Jackhammer9/Ottolink/CAD/Designed/UpperArm.stp

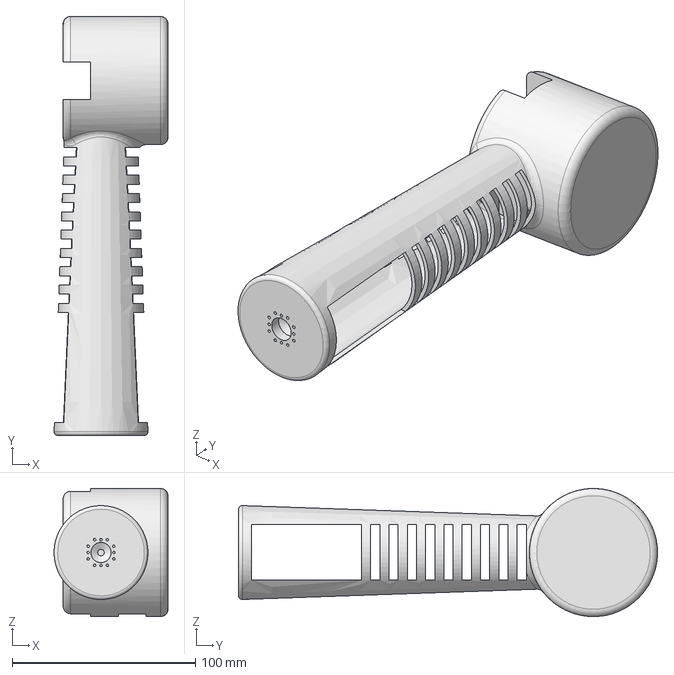
[picture p2: CAD file, 2026-09-29]
CAD/Designed/UpperArm.stp
62.2 x 228.9 x 70.0 mm
