Jackhammer9/Ottolink/Sim/meshes/rollmotor.stl

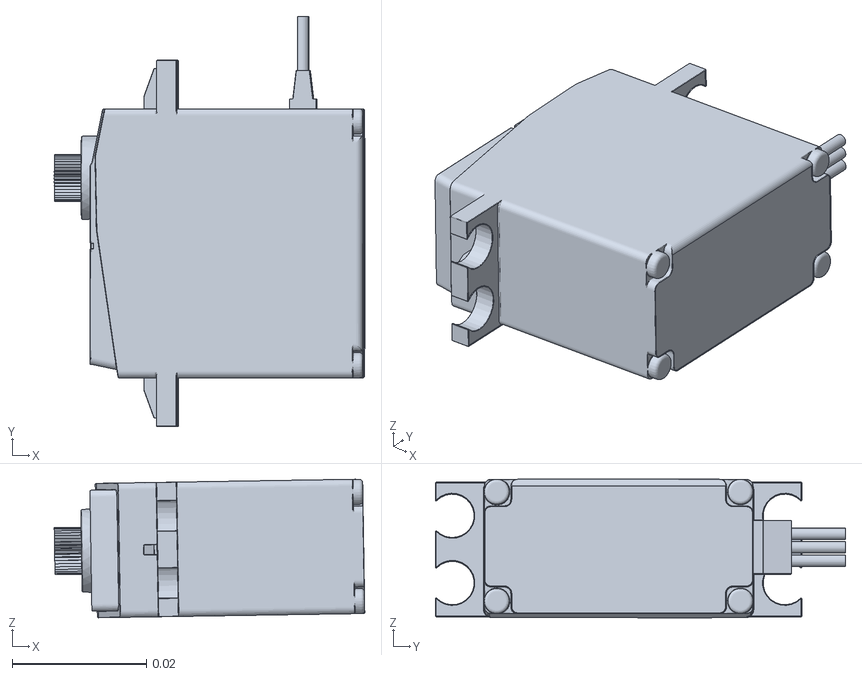
[picture p3: CAD file, 2026-09-29]
Sim/meshes/rollmotor.stl
0.0462 x 0.061 x 0.0206
