Jackhammer9/Ottolink/CAD/Designed/LowArm.stp

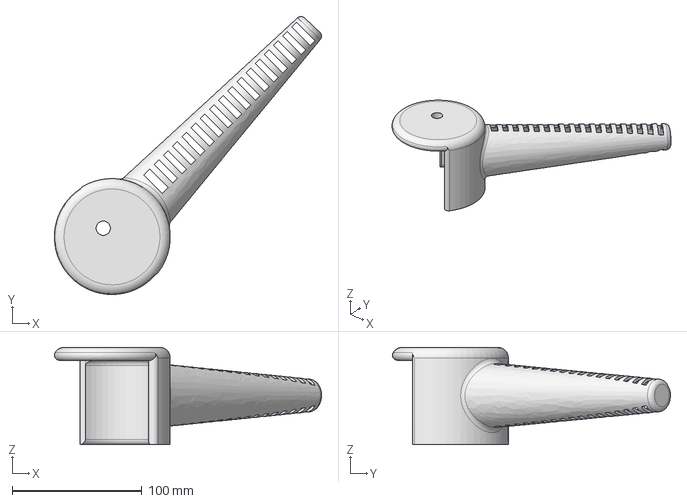
[picture p4: CAD file, 2026-09-29]
CAD/Designed/LowArm.stp
206.2 x 214.6 x 75.0 mm
