Jackhammer9/Ottolink/Sim/meshes/upperarm_1.stl

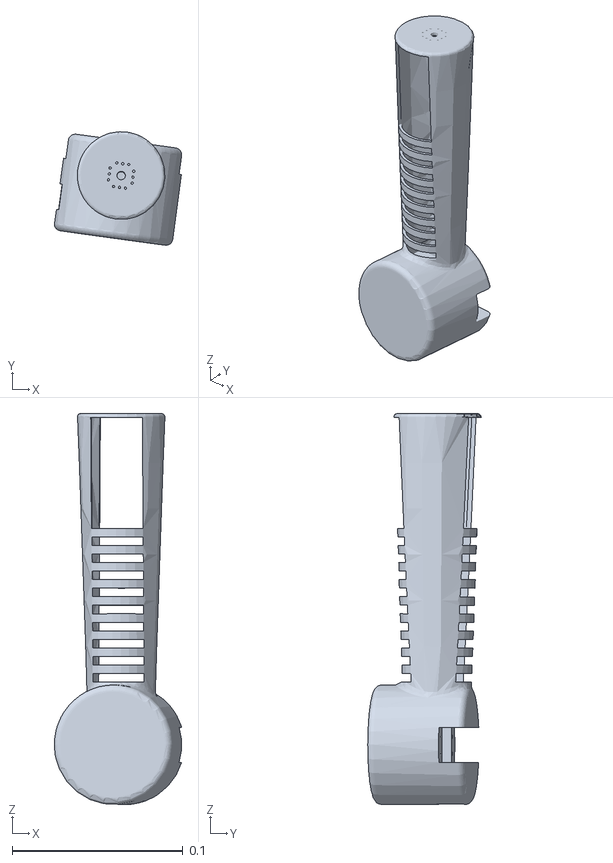
[picture p5: CAD file, 2026-09-29]
Sim/meshes/upperarm_1.stl
0.0746 x 0.0665 x 0.229
