Jackhammer9/Ottolink/CAD/Designed/RollServoMount.stp

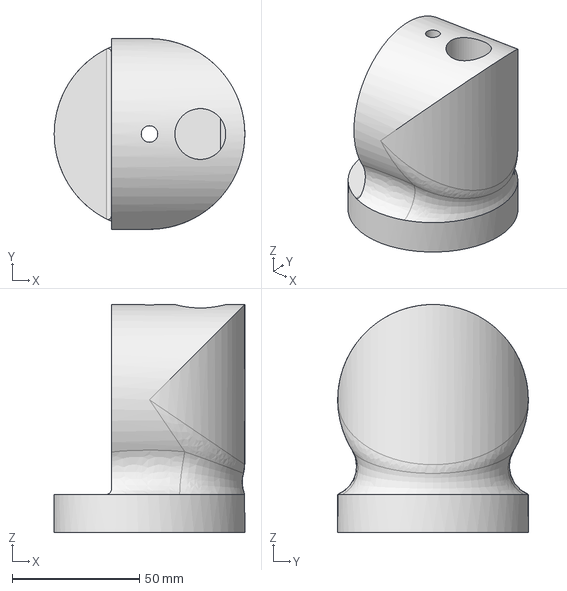
[picture p6: CAD file, 2026-09-29]
CAD/Designed/RollServoMount.stp
75.0 x 75.0 x 89.7 mm
