Jackhammer9/Ottolink/Sim/meshes/yawmotorholder.stl

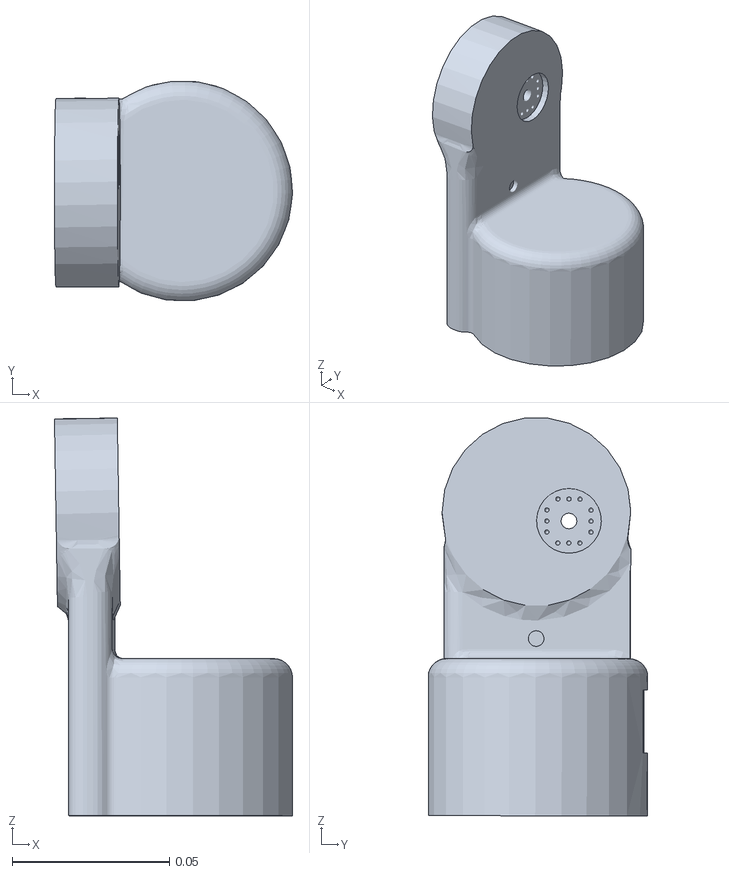
[picture p7: CAD file, 2026-09-29]
Sim/meshes/yawmotorholder.stl
0.0757 x 0.0698 x 0.127
