Jackhammer9/Ottolink/CAD/Designed/YawMotorHolder.stp

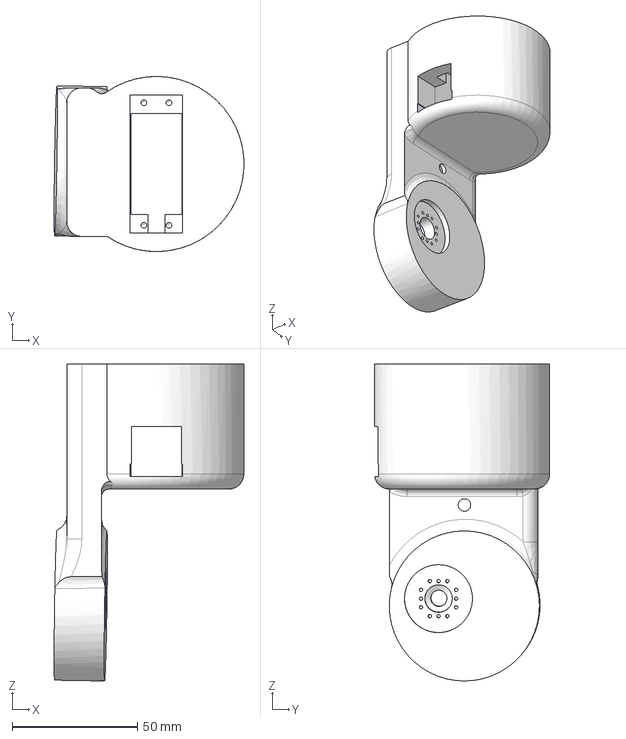
[picture p8: CAD file, 2026-09-29]
CAD/Designed/YawMotorHolder.stp
75.9 x 70.0 x 126.7 mm
