Jackhammer9/Ottolink/Sim/meshes/pitchmotor.stl

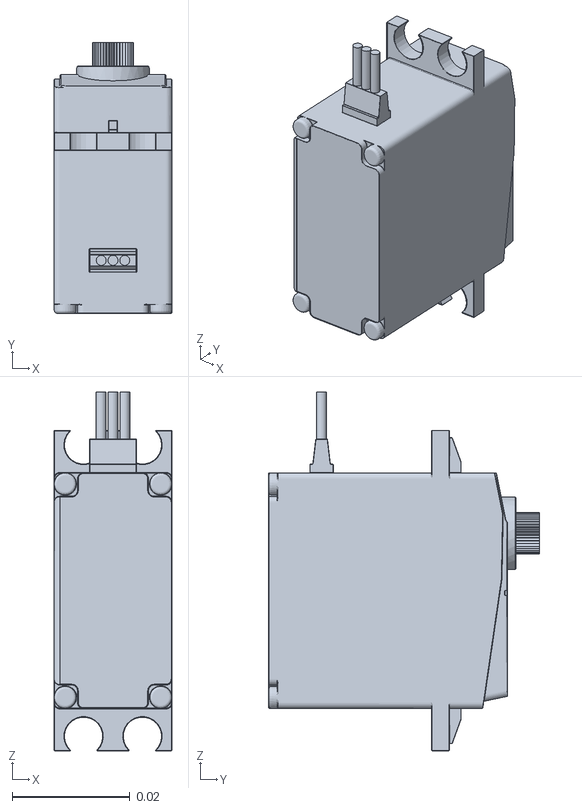
[picture p9: CAD file, 2026-09-29]
Sim/meshes/pitchmotor.stl
0.02 x 0.046 x 0.061
