Jackhammer9/Ottolink/CAD/Designed/PitchMotorHolder.stp

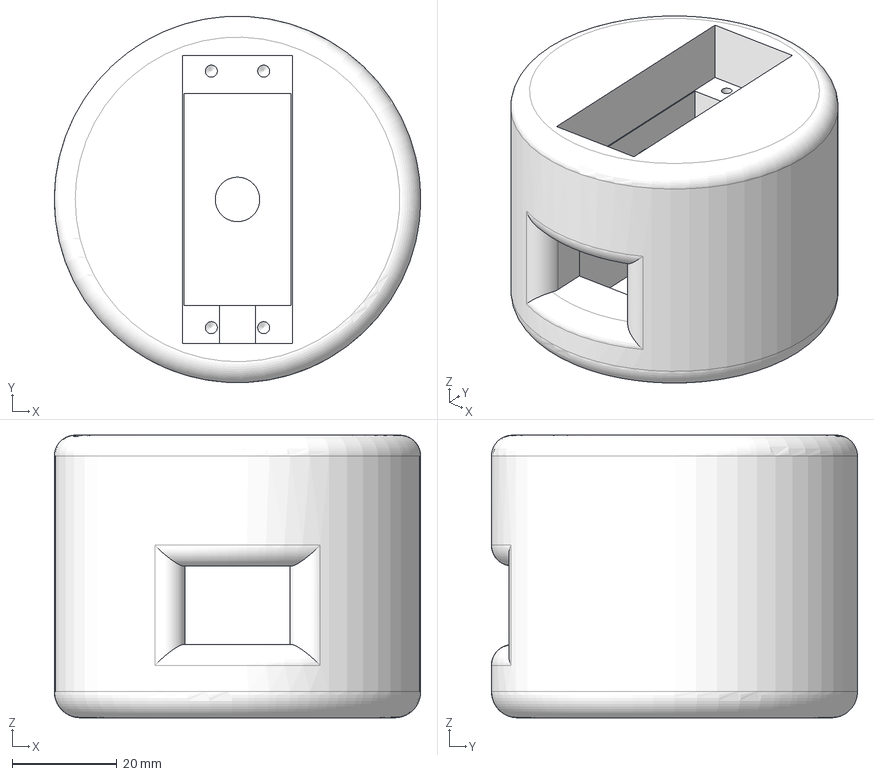
[picture p10: CAD file, 2026-09-29]
CAD/Designed/PitchMotorHolder.stp
70.0 x 69.9 x 54.0 mm
