Jackhammer9/Ottolink/Sim/meshes/yawhorn.stl

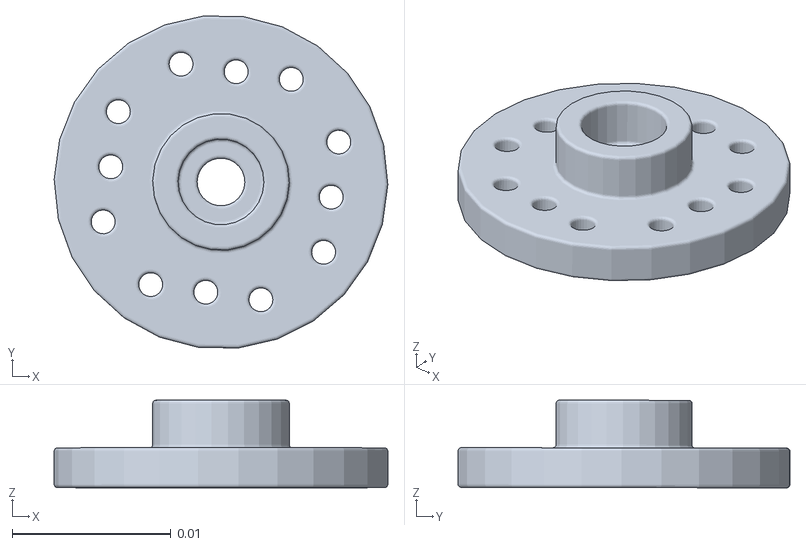
[picture p11: CAD file, 2026-09-29]
Sim/meshes/yawhorn.stl
0.021 x 0.0209 x 0.00552
