Jackhammer9/Ottolink/Sim/meshes/elbow_horn.stl

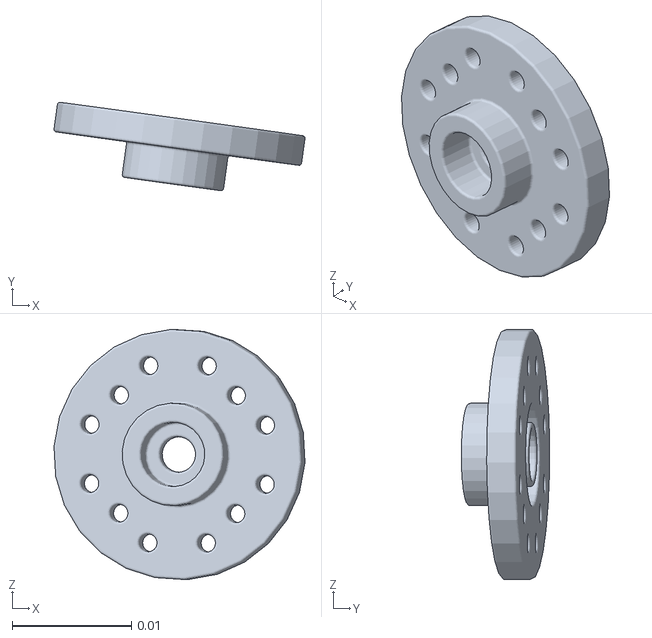
[picture p12: CAD file, 2026-09-29]
Sim/meshes/elbow_horn.stl
0.021 x 0.00741 x 0.021
