Jackhammer9/Ottolink/Sim/meshes/rollservomount_1.stl

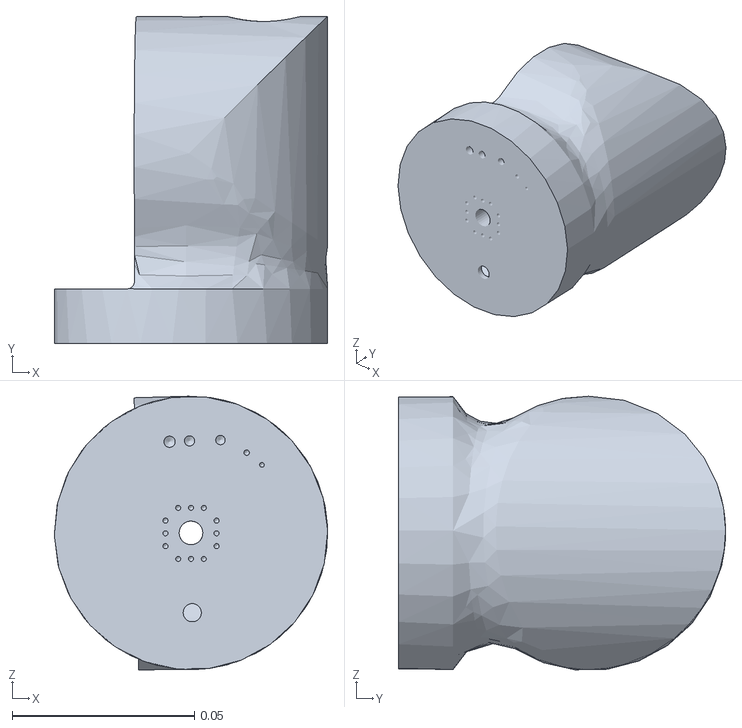
[picture p13: CAD file, 2026-09-29]
Sim/meshes/rollservomount_1.stl
0.075 x 0.0897 x 0.075
