Jackhammer9/Ottolink/Sim/meshes/pitchmotorholder_1.stl

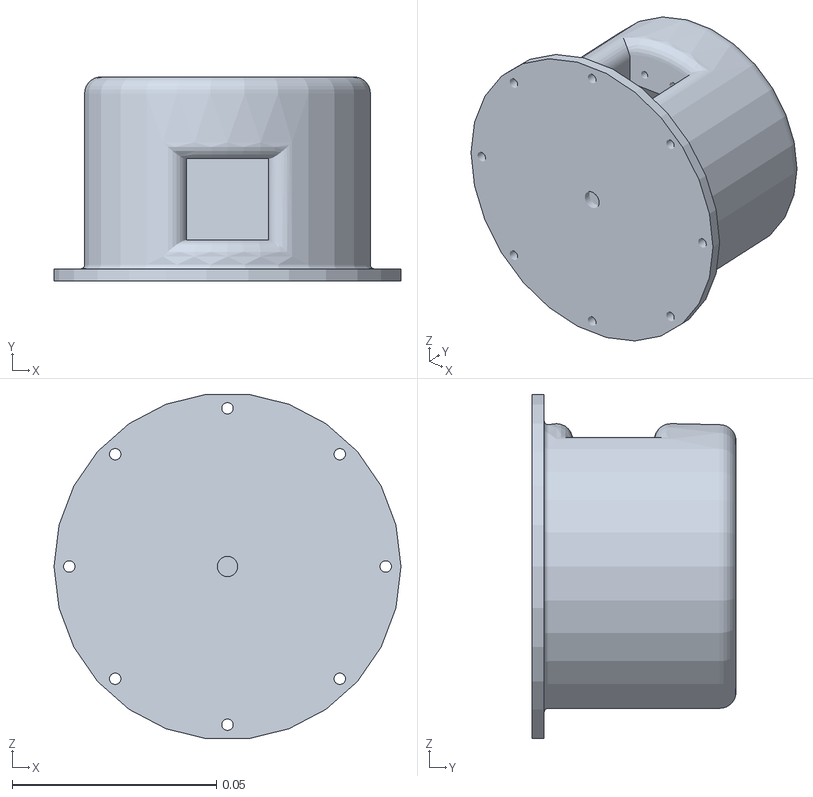
[picture p14: CAD file, 2026-09-29]
Sim/meshes/pitchmotorholder_1.stl
0.085 x 0.05 x 0.0844
