Jackhammer9/Ottolink/Sim/meshes/lowarm_1.stl

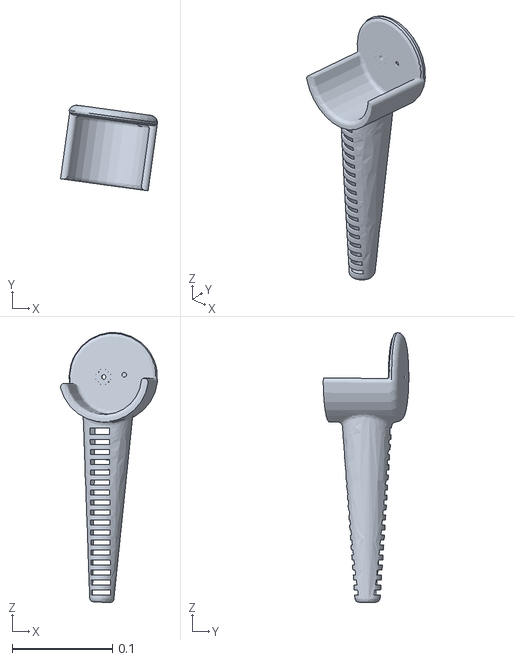
[picture p15: CAD file, 2026-09-29]
Sim/meshes/lowarm_1.stl
0.0968 x 0.0855 x 0.27
