Jackhammer9/Ottolink/Sim/meshes/elbowmotor.stl

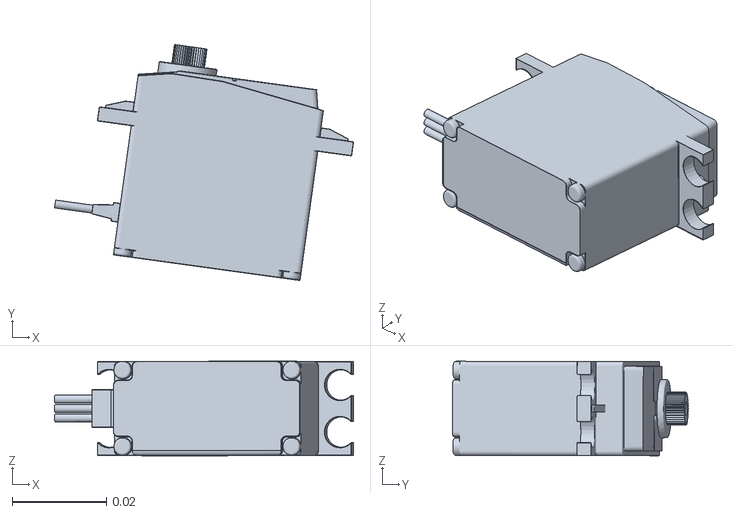
[picture p16: CAD file, 2026-09-29]
Sim/meshes/elbowmotor.stl
0.0635 x 0.0501 x 0.0201
