Jackhammer9/Ottolink/Sim/meshes/rollhorn.stl

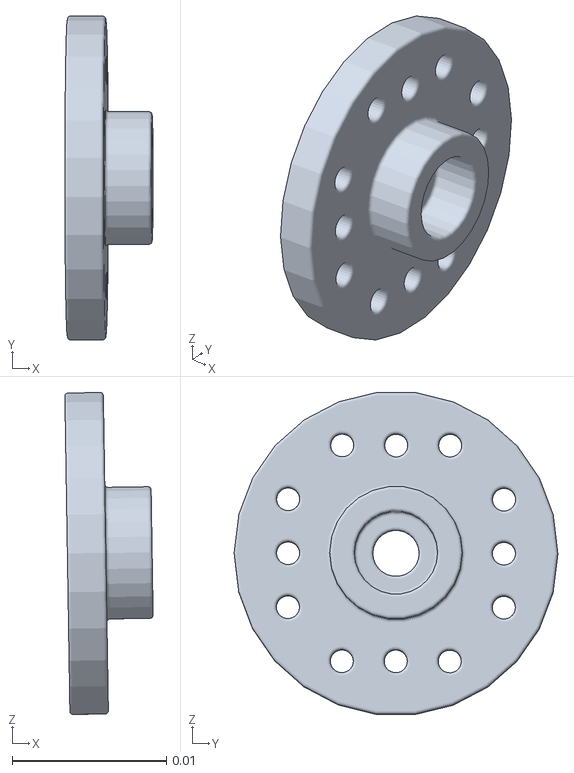
[picture p17: CAD file, 2026-09-29]
Sim/meshes/rollhorn.stl
0.00573 x 0.021 x 0.0209
