Jackhammer9/Ottolink/(list of files, cad)

Other CAD files:
Sim/meshes/pitchhorn.stl
Sim/meshes/yawmotor.stl
CAD/Designed/.ipt/LowArm.ipt
CAD/Designed/.ipt/OldVersions/PitchMotorHolder.0004.ipt
CAD/Designed/.ipt/OldVersions/Robot.0005.iam
CAD/Designed/.ipt/OldVersions/YawMotorHolder.0001.ipt
CAD/Designed/.ipt/PitchMotorHolder.ipt
CAD/Designed/.ipt/Robot.iam
CAD/Designed/.ipt/RollServoMount.ipt
CAD/Designed/.ipt/UpperArm.ipt
CAD/Designed/.ipt/YawMotorHolder.ipt
CAD/Downloaded/Circular Servo Horn.ipt
CAD/Downloaded/DS3225MG 25KG.ipt
CAD/Downloaded/LowArm.ipt
CAD/Downloaded/LowerArm.ipt
CAD/Downloaded/MG995.ipt
CAD/Downloaded/OldVersions/Circular Servo Horn.0001.ipt
CAD/Downloaded/OldVersions/DS3225MG 25KG.0001.ipt
CAD/Downloaded/OldVersions/LowArm.0004.ipt
