Jackhammer9/Ottolink/OttolinkPCB/OttolinkPCB.kicad_pcb

## KiCad design OttolinkPCB/OttolinkPCB.kicad_pcb (2026-09-29)

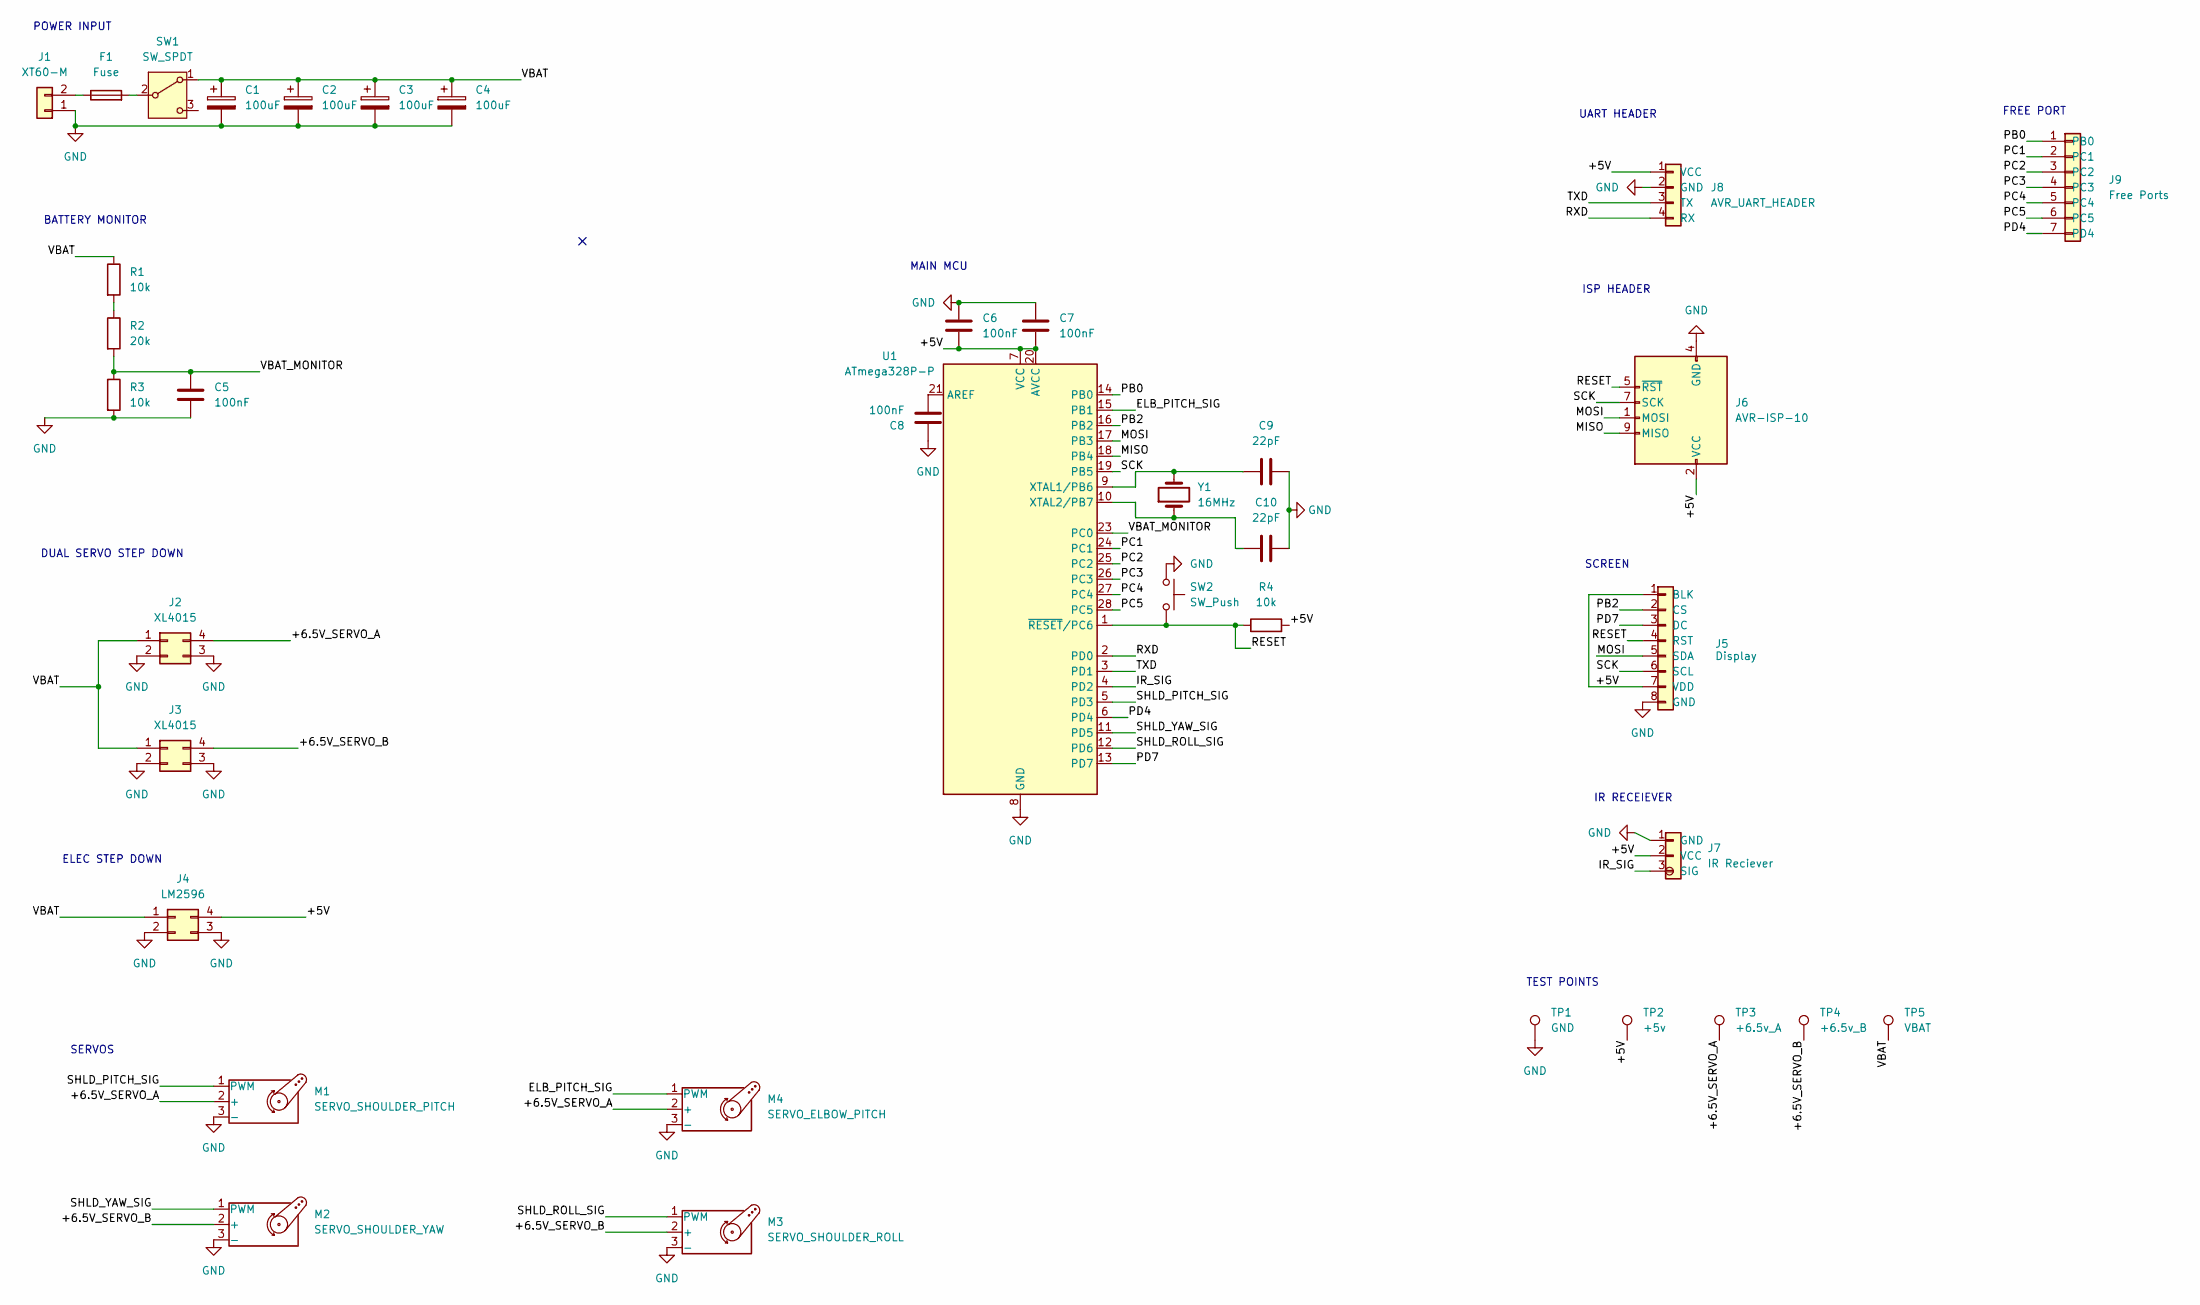
[picture p18: schematic OttolinkPCB.kicad_sch, OttoLink]

Parts:
C1, C2, C3, C4: 100uF; CP_Radial_D5.0mm_P2.00mm
C5, C6, C7, C8: 100nF; C_0805_2012Metric_Pad1.18x1.45mm_HandSolder
C9, C10: 22pF; C_Disc_D5.0mm_W2.5mm_P5.00mm
F1: Fuse; Fuseholder_Cylinder-5x20mm_Schurter_0031_8201_Horizontal_Op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
J1: XT60-M; AMASS_XT60-M_1x02_P7.20mm_Vertical
J2, J3: XL4015
J4: LM2596; LM2596 Step Down Module
J5: Display; PinHeader_1x08_P2.54mm_Vertical
J6: AVR-ISP-10; PinHeader_2x05_P2.54mm_Vertical
J7: IR Reciever; PinHeader_1x03_P2.54mm_Vertical
J8: AVR_UART_HEADER; PinHeader_1x04_P2.54mm_Vertical
J9: Free Ports; PinHeader_1x07_P2.54mm_Vertical
M1: SERVO_SHOULDER_PITCH; PinHeader_1x03_P2.54mm_Vertical
M2: SERVO_SHOULDER_YAW; PinHeader_1x03_P2.54mm_Vertical
M3: SERVO_SHOULDER_ROLL; PinHeader_1x03_P2.54mm_Vertical
M4: SERVO_ELBOW_PITCH; PinHeader_1x03_P2.54mm_Vertical
R1, R3, R4: 10k; R_Axial_DIN0207_L6.3mm_D2.5mm_P7.62mm_Horizontal
R2: 20k; R_Axial_DIN0207_L6.3mm_D2.5mm_P7.62mm_Horizontal
SW1: SW_SPDT; PinHeader_1x03_P2.54mm_Vertical
SW2: SW_Push; SW_PUSH_6mm
TP1: GND; TestPoint_Pad_D2.0mm
TP2: +5v; TestPoint_Pad_D2.0mm
TP3: +6.5v_A; TestPoint_Pad_D2.0mm
TP4: +6.5v_B; TestPoint_Pad_D2.0mm
TP5: VBAT; TestPoint_Pad_D2.0mm
U1: ATmega328P-P; DIP-28_W7.62mm
Y1: 16MHz; Crystal_HC49-4H_Vertical

Connections:
/+5V: C6.2, C7.2, J4.4, J5.1 (BLK), J5.7 (VDD), J6.2 (VCC), J7.2 (VCC), J8.1 (VCC), R4.2, TP2.1 (1_1), U1.7 (VCC), U1.20 (AVCC)
/+6.5V_SERVO_A: J2.4, M1.2 (+), M4.2 (+), TP3.1 (1_1)
/+6.5V_SERVO_B: J3.4, M2.2 (+), M3.2 (+), TP4.1 (1_1)
/ELB_PITCH_SIG: M4.1 (PWM), U1.15 (PB1)
/IR_SIG: J7.3 (SIG), U1.4 (PD2)
/MISO: J6.9 (MISO), U1.18 (PB4)
/MOSI: J5.5 (SDA), J6.1 (MOSI), U1.17 (PB3)
/PB0: J9.1 (PB0), U1.14 (PB0)
/PB2: J5.2 (CS), U1.16 (PB2)
/PC1: J9.2 (PC1), U1.24 (PC1)
/PC2: J9.3 (PC2), U1.25 (PC2)
/PC3: J9.4 (PC3), U1.26 (PC3)
/PC4: J9.5 (PC4), U1.27 (PC4)
/PC5: J9.6 (PC5), U1.28 (PC5)
/PD4: J9.7 (PD4), U1.6 (PD4)
/PD7: J5.3 (DC), U1.13 (PD7)
/RESET: J5.4 (RST), J6.5 (~RST), R4.1, SW2.2, U1.1 (~RESET/PC6)
/RXD: J8.4 (RX), U1.2 (PD0)
/SCK: J5.6 (SCL), J6.7 (SCK), U1.19 (PB5)
/SHLD_PITCH_SIG: M1.1 (PWM), U1.5 (PD3)
/SHLD_ROLL_SIG: M3.1 (PWM), U1.12 (PD6)
/SHLD_YAW_SIG: M2.1 (PWM), U1.11 (PD5)
/TXD: J8.3 (TX), U1.3 (PD1)
/VBAT: C1.1, C2.1, C3.1, C4.1, J2.1, J3.1, J4.1, R1.1, SW1.1 (A), TP5.1 (1_1)
/VBAT_MONITOR: C5.1, R2.2, R3.1, U1.23 (PC0)
GND: C1.2, C2.2, C3.2, C4.2, C5.2, C6.1, C7.1, C8.1, C9.2, C10.1, J1.1, J2.2, J2.3, J3.2, J3.3, J4.2, J4.3, J5.8 (GND), J6.4 (GND), J6.6 (GND), J6.8 (GND), J6.10 (GND), J7.1 (GND), J8.2 (GND), M1.3 (-), M2.3 (-), M3.3 (-), M4.3 (-), R3.2, SW2.1, TP1.1 (1_1), U1.8 (GND), U1.22 (GND)
unnamed: F1.1, J1.2
unnamed: R1.2, R2.1
unnamed: F1.2, SW1.2 (B)
unnamed: C8.2, U1.21 (AREF)
unnamed: C9.1, U1.9 (XTAL1/PB6), Y1.2
unnamed: C10.2, U1.10 (XTAL2/PB7), Y1.1

Notes on the sheet:
DUAL SERVO STEP DOWN
BATTERY MONITOR
TEST POINTS
IR RECEIEVER
FREE PORT
SCREEN
ELEC STEP DOWN
MAIN MCU
SERVOS
POWER INPUT
ISP HEADER
UART HEADER

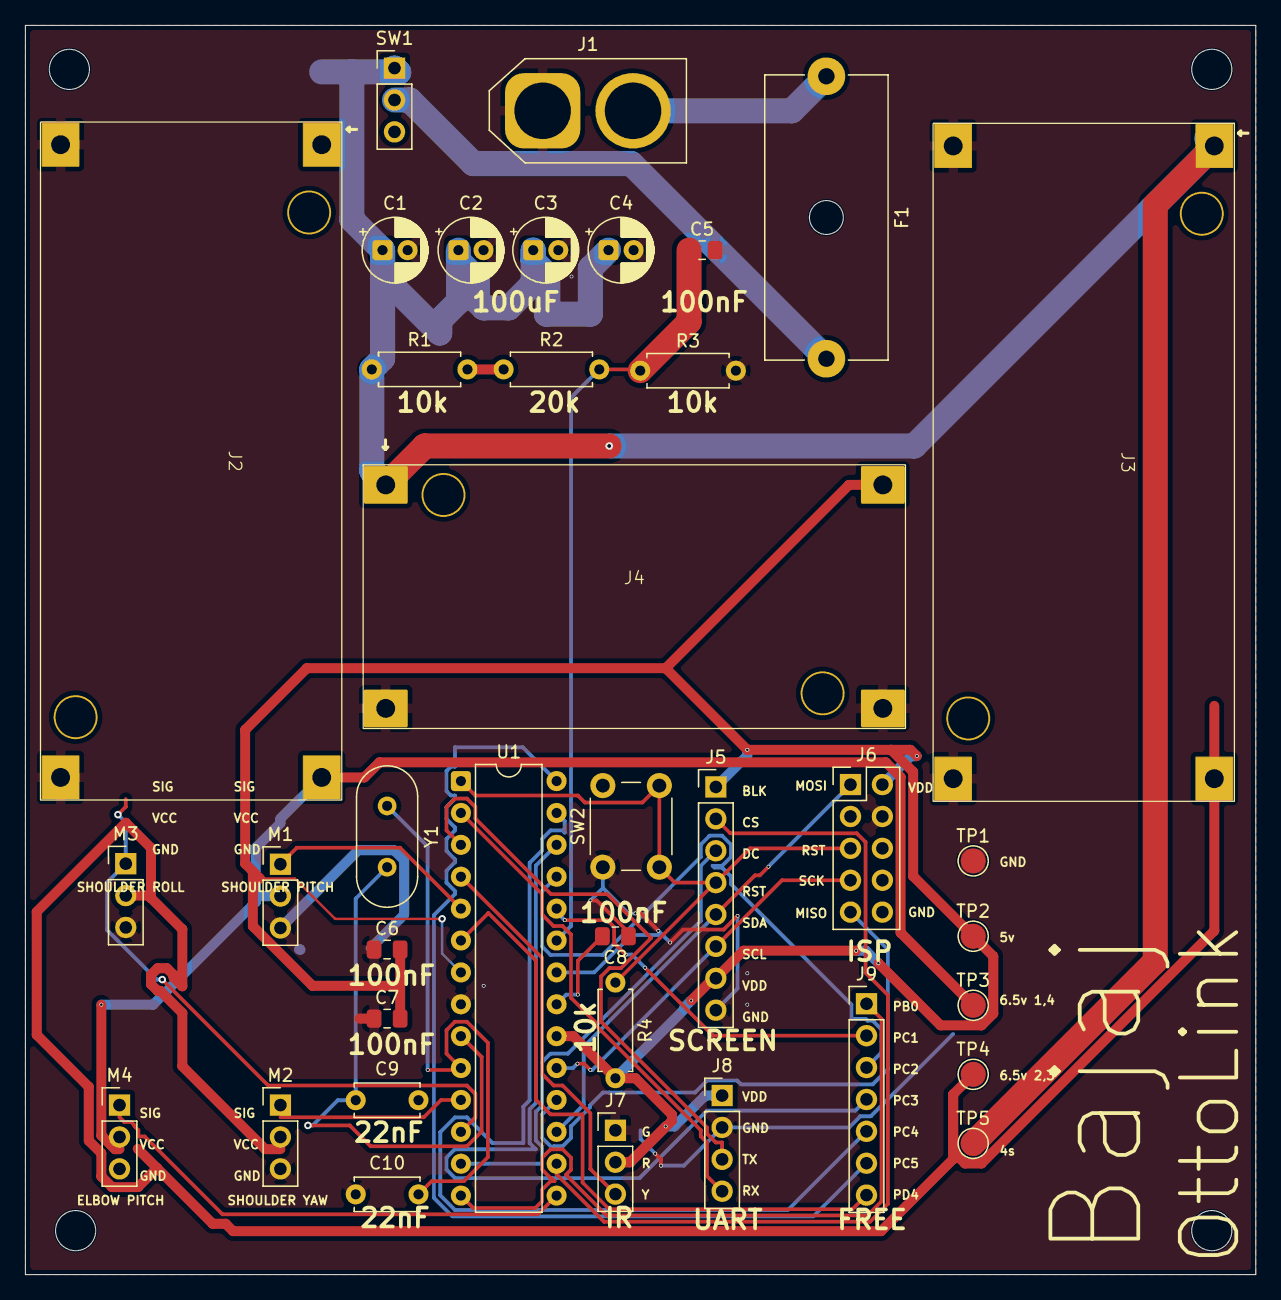
[picture p19: board OttolinkPCB.kicad_pcb from above]

Board: 2 copper layers, 98.0 x 99.5 mm, 37 parts (0 on the bottom side), 32 nets.
