Jackhammer9/Ottolink/(commit log)

2026-09-29 Refactor README for clarity and structure
    Updated the README to enhance clarity and structure, including sections on mechanical design, kinematics, control, electronics, and simulation. Removed redundant logo and improved formatting.
2026-09-29 Add 'Watch It In Action' section to README
    Added a section to the README to link to the portfolio website showcasing the arm in action.
